espena/kicad-libs/README

# kicad-libs

Customized symbols, footprints and 3D models for my personal KiCad projects. Completely open and free for anyone to use - at own risk.

## My 3D STEP models

The models are made in [FreeCAD](https://www.freecad.org/) and exported as KiCad-importable STEP files. The models are located in the [/espena/3dmodels](/espena/3dmodels) directory.

### BatteryHolder_ELM_1xCR123A

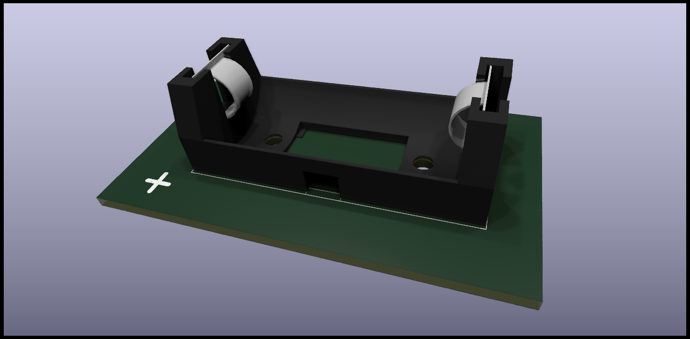
[picture p1: espena/renderings/BatteryHolder_ELM_1xCR123A.png]
3D rendering BatteryHolder_ELM_1xCR123A
