espena/kicad-libs/mouser/README.md

# Third party 3D model

Not included in public repo.

Mouser/SamacSys models may be download from [Mouser](https://no.mouser.com/electronic-cad-symbols-models/)
