espena/kicad-libs/snapeda/3dmodels/Diode_SMD_snapeda/README.md

# Third party 3D model

Not included in public repo.

HDS20M-13.step may be downloaded from [SnapEDA](https://www.snapeda.com/parts/HDS20M-13/Diodes%20Inc./view-part/)
DO-214AA.STEP may be downloaded from [SnapEDA](https://www.snapeda.com/parts/SS24/ON%20Semiconductor/view-part/)
