espena/kicad-libs/snapeda/3dmodels/RF_Modules_snapeda/README.md

# Third party 3D model

Not included in public repo.

ESP32-WROVER-B.step may be download from [SnapEDA](https://www.snapeda.com/parts/ESP32-WROVER-I/Espressif%20Systems/view-part/)
