espena/kicad-libs/espena/renderings/Fuse_MXT250.png

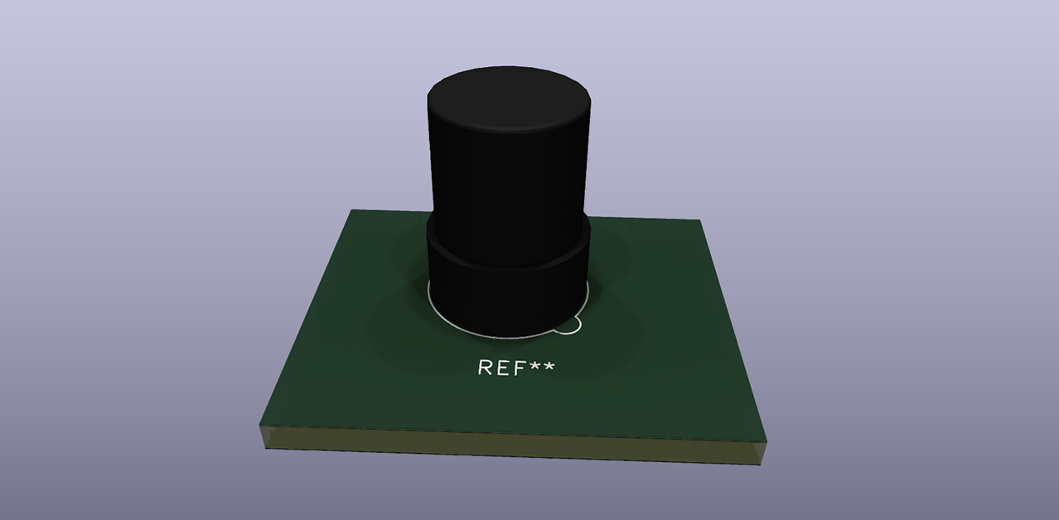
espena/renderings/Fuse_MXT250.png
