espena/kicad-libs/espena/renderings/Heatsink_3.5mmx3.5mmx2.5mm.png

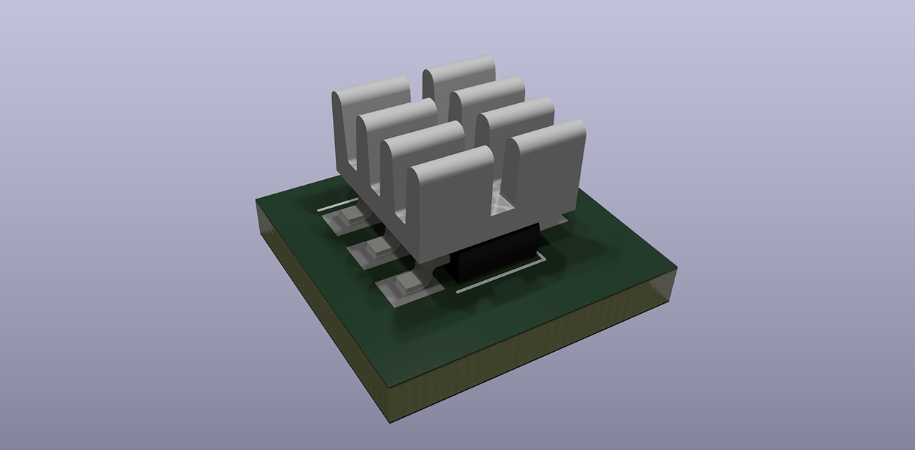
espena/renderings/Heatsink_3.5mmx3.5mmx2.5mm.png
