espena/kicad-libs/espena/renderings/PinHeader_1x04_P1.27mm_Vertical_without_pin2.png

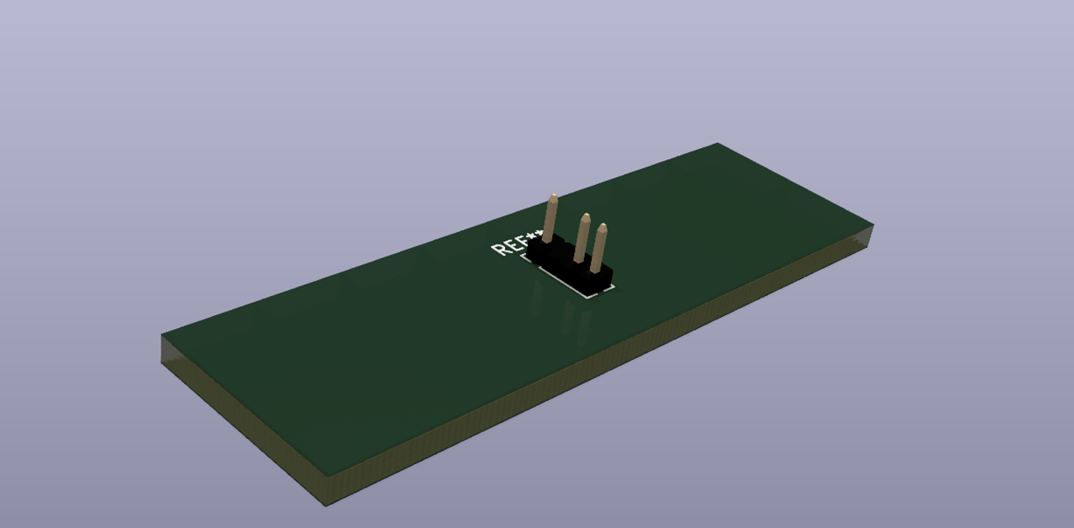
espena/renderings/PinHeader_1x04_P1.27mm_Vertical_without_pin2.png
