espena/kicad-libs/espena/renderings/Relay_DPDT_Tianbo_HJR-1-2C.png

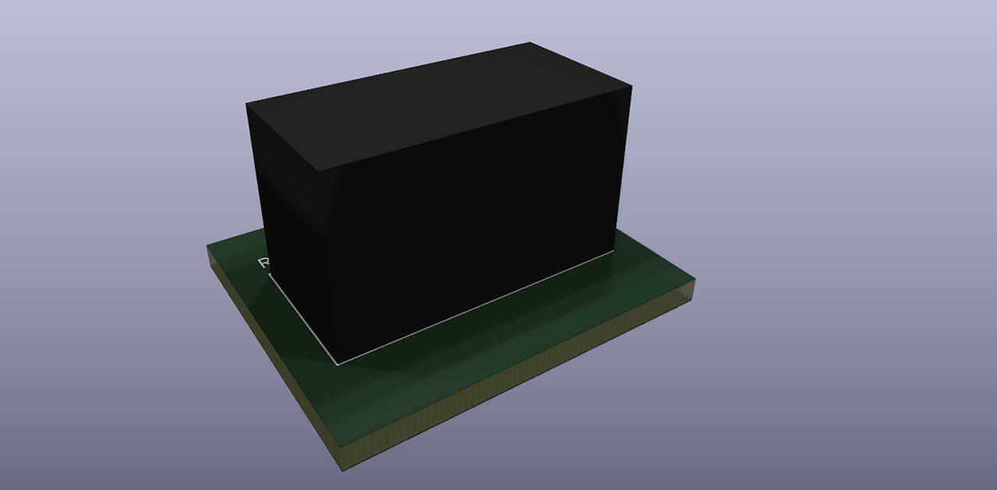
espena/renderings/Relay_DPDT_Tianbo_HJR-1-2C.png
