espena/kicad-libs/espena/renderings/SW_SPST_TL3301_6x6mm_H4.3mm.png

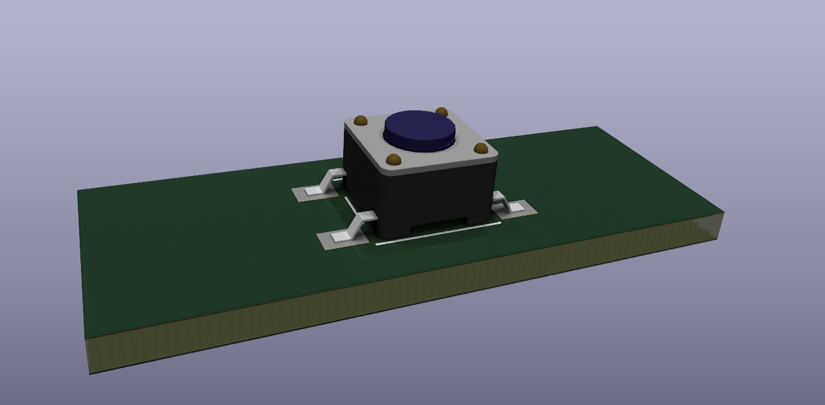
espena/renderings/SW_SPST_TL3301_6x6mm_H4.3mm.png
