espena/kicad-libs/espena/renderings/Unbranded_VS1838B.png

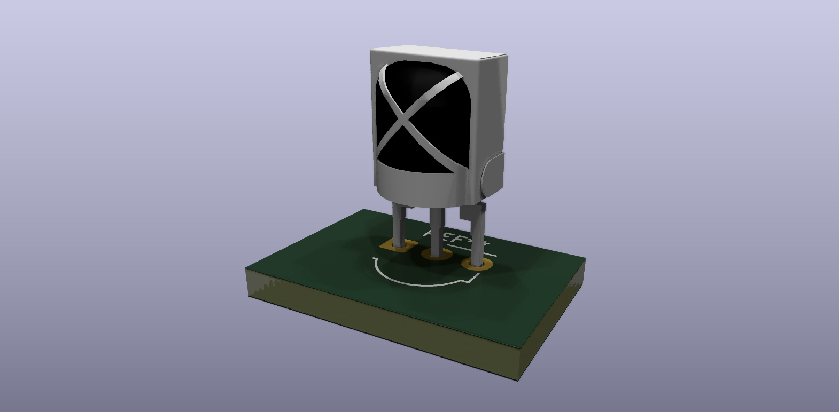
espena/renderings/Unbranded_VS1838B.png
