espena/kicad-libs/espena/3dmodels/DC044_connector_5.5x2.1mm/DC044_connector_5.5x2.1mm.step

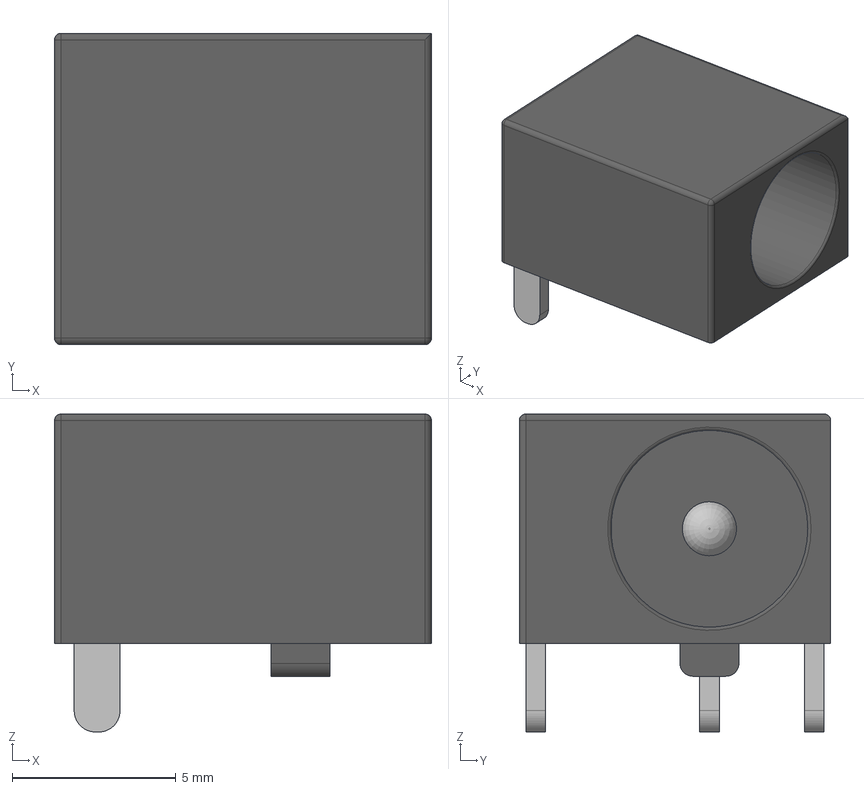
[picture p8: CAD file, 2024-05-18, last stored version]
espena/3dmodels/DC044_connector_5.5x2.1mm/DC044_connector_5.5x2.1mm.step
11.5 x 9.50 x 9.70 mm
Housing
Center pin
Connector 2
Connector 3
Connector 4
