espena/kicad-libs/espena/3dmodels/Display_OLED_0.96_128x64/Display_OLED_0.96_128x64.step

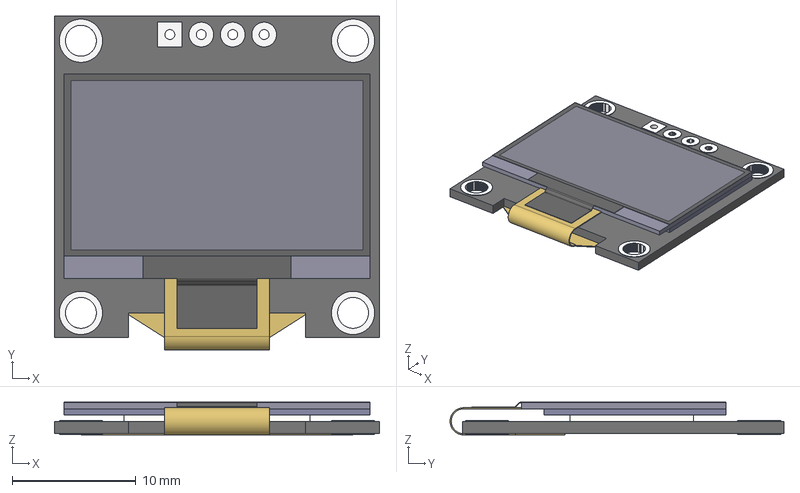
[picture p9: CAD file, 2023-10-20, last stored version]
espena/3dmodels/Display_OLED_0.96_128x64/Display_OLED_0.96_128x64.step
26.3 x 27.0 x 2.65 mm
Body - PCB
Body - Back Panel
Body - Adhesive Pad
Body - Front Panel
Body - Flex Connector Bend
Body - Flex Connector Terminals
Body - Black Tape
Body - Protective Foil
Body - Screen Border
Extrude - Annular Rings
