espena/kicad-libs/espena/3dmodels/TP094003_Transducer_9x9mm/TP094003_Transducer_9x9mm.step

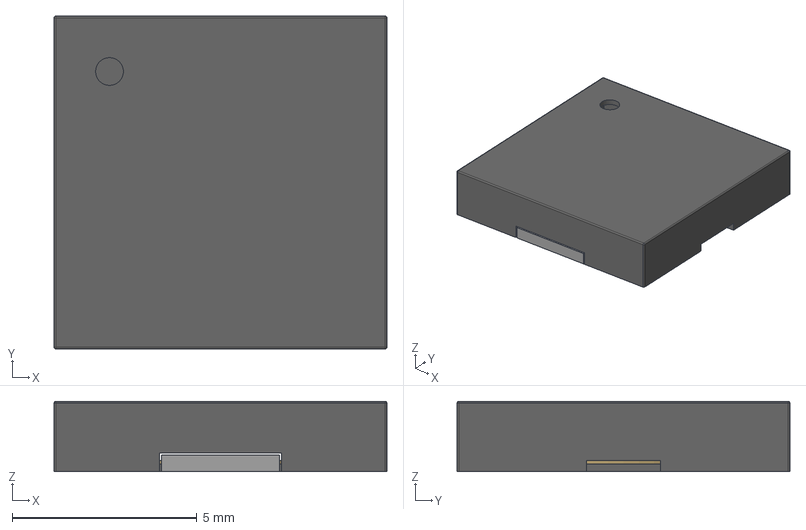
[picture p10: CAD file, 2023-10-20, last stored version]
espena/3dmodels/TP094003_Transducer_9x9mm/TP094003_Transducer_9x9mm.step
9.00 x 9.00 x 1.90 mm
Body - Encapsulation
Body - Terminal 1 x 2
Body - Transducer disc
