espena/kicad-libs/(commit log)

2023-02-18 Add symbol and footprint for VS1838B
2023-04-01 Add footprint and 3D for CR123A battery holder
2023-04-01 Remove name postfix, use nickname in KiCad instead
2023-04-03 Small adjustments to pin positions
2023-04-07 Align footprint anchor with pin 1
2023-05-14 Add sumbol for ESP32-Wrover-B module
2023-05-14 Update ESP32 unit
2023-05-18 Adapt ESP32 WROVER to schematic
2023-05-19 Update ESP32 WROVER-B pin layout
2023-05-20 Add scaled-down, special purpose decoupling capacitor
2023-05-20 Amend pin placement for MAX3232
2023-05-20 Amend pin placement for ESP32-WROVER-B
2023-05-20 Add DS3231 RTC circuit
2023-05-21 Add Tianbo HJR1-2C relay
2023-05-21 Add footprint for Tianbo HJR1-2C relay
2023-05-21 Add footprint for ESP32-WROVER-B
2023-05-22 Correct wrong pin numering on pin 14
2023-05-22 Add Keystone 3554 fuse holder
2023-05-27 Add tactile push button
2023-05-27 Add courtyards to footprints
2023-05-27 Adjustment: Include only solder pads in back side court yard
2023-05-27 Add 3D model for Tianbo HJR 1-2C relay
2023-05-27 Add 3D model for tactile pushbutton switch TL3301
2023-05-31 Remove silk screen around antenna to avoid 'outside board edge' warnings
2023-06-11 Set pin numbering according to datasheet
2023-06-21 Adapt WROOM module to new circuit layout
2023-06-22 Rearrange pins to simplify schematics
2023-06-24 New and amended symbols for dual-button door bell
2023-06-27 Add 4x1 pin header with pin 2 removed
2023-06-27 Add spaced pin header
2023-07-11 Reorganize pin for additional rtc control line
2023-08-22 SOT-223 with thermal pads and heatsink
2023-08-22 3D rendering of heatsink
2023-08-25 Add entry for Heatsink_6.5x6.5x3.5mm
2023-09-03 Add double heatsinked version
2023-09-03 Add 3-cell battery
2023-10-20 Add MOSFETs
2023-10-20 Adding 3xAAA cell battery holder
2023-10-20 Add OLED display model
    [Display_OLED_0.96_128x64.step]
2023-10-20 Add wire jumper
2023-10-20 Footprint for OLED display
2023-10-20 Add footprints for wire jumpers
2023-10-20 ADD piezo sound transducer
    [TP094003_Transducer_9x9mm.step]
2023-10-20 Symbol with board antenna cutout
2024-04-30 Tiny LED for drawing diode matrices
2024-04-30 Add ESP32 WROVER-E with custom pinout
2024-04-30 Add 'cuttable wire'
2024-04-30 Add customized LED driver circuits
2024-05-11 Update with new symbols, footprints, 3D models
2024-05-18 Adding components for broadcast clock project
    [DC044_connector_5.5x2.1mm.step]
2024-05-19 Set footprint for GPS antenna
2024-05-19 Add custom footprint and 3D model for U-Blox LEA-M8T module
2025-08-02 Add footprint and model for Honyone PB26 RGB pushbutton
2025-08-07 Add symbol for Honyone PB26 RGB button
2025-08-07 Hide pin numbers
2025-08-16 Adding footprint for SJMS tactile pushbutton
2026-04-06 Add board edge indicator LED footprint / model
2026-04-06 Footprint for tall tactile pushbutton
2026-04-10 Add new footprints and 3Dmodels
